mikeyfarrow/DFAM-x-ATMEGA/THT_PCB_rough-layout.PNG

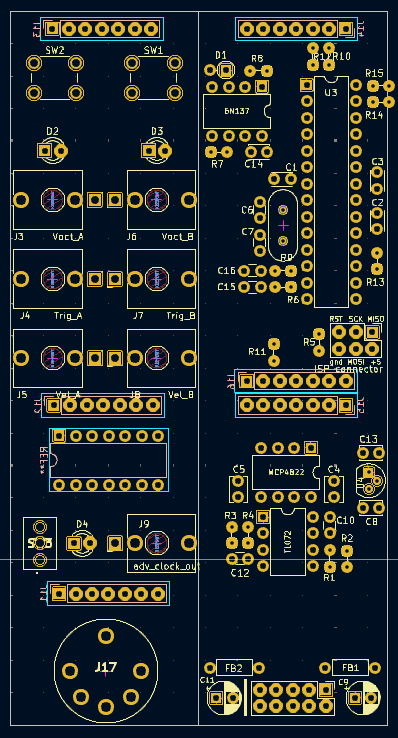
THT_PCB_rough-layout.PNG
