mikeyfarrow/DFAM-x-ATMEGA/PCB_Design_Kicad/fab/bom_JLCPCB_download.xls

Comment | Designator | Footprint | JLCPCB Part #
100n | C13,C1,C2,C3,C10,C12,C14,C13,C1,C2,C3,C10,C12,C14 | 0603 | C14663
47k | R2,R4,R16,R17 | 0603 | C25819
10u | C9,C11 | CP_Elec_5x5.4 | C263975
10k | R6,R9,R11,R12,R13,R15,R24 | 0603 | C25804
150n | C18 | 0603 | C21120
1N4148 | D1,D7 | SOD-323 | C2128
56k | R21,R23 | 0603 | C23206
33k | R20,R22 | 0603 | C4216
1k | R7,R18,R19 | 0603 | C21190
1u | C4,C15,C17 | 0603 | C15849
220R | R5,R8,R10,R14 | 0603 | C22962
OPA4196xD | U4 | TSSOP-14 | C2873620
DAC8562SDGSR | IC1 | VSSOP-10-0.5mm | C127965
6N137 | U5 | SMD8 | C92651
240k | R1,R3 | 0603 | C407611
0.33u | C8 | 0603 | C1623
ATmega328-A | U6 | TQFP-32_7x7mm_P0.8mm | C14877
rppdiode | D5,D6 | SOD-123F | C8598
18p | C5,C6,C7,C16 | 0603 | C1647
