mikeyfarrow/DFAM-x-ATMEGA/PCB_Design_Kicad/fab/panel_MIDIFAM.step

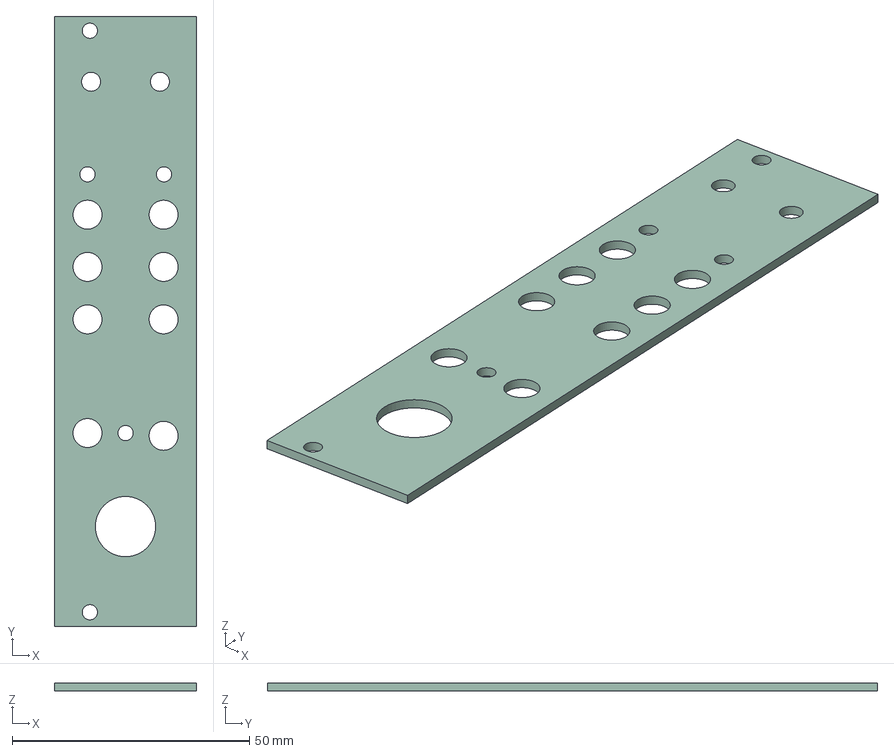
[picture p2: CAD file, 2024-08-22]
PCB_Design_Kicad/fab/panel_MIDIFAM.step
30.0 x 128.5 x 1.60 mm
