mikeyfarrow/DFAM-x-ATMEGA/PCB_Design_Kicad/fab/controls.step

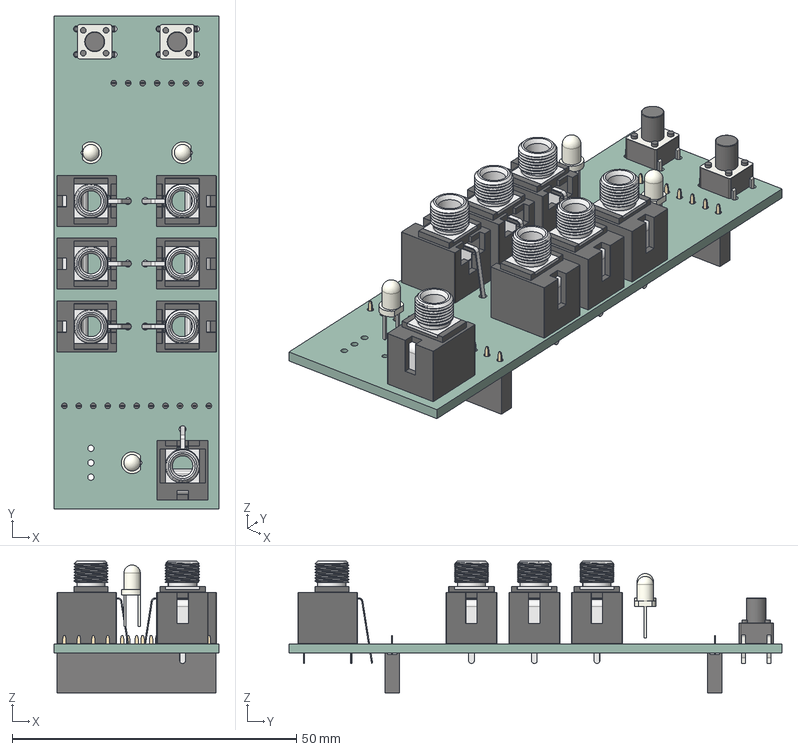
[picture p3: CAD file, 2024-08-22]
PCB_Design_Kicad/fab/controls.step
29.0 x 86.6 x 23.2 mm
LED_D3.0mm_Clear x 3
SW_PUSH_6mm_h8mm x 2
PinSocket_1x07_P254mm_Vertical
PinSocket_1x11_P254mm_Vertical
controls_PCB
