mikeyfarrow/DFAM-x-ATMEGA/PCB_Design_Kicad/fab/circuit.step

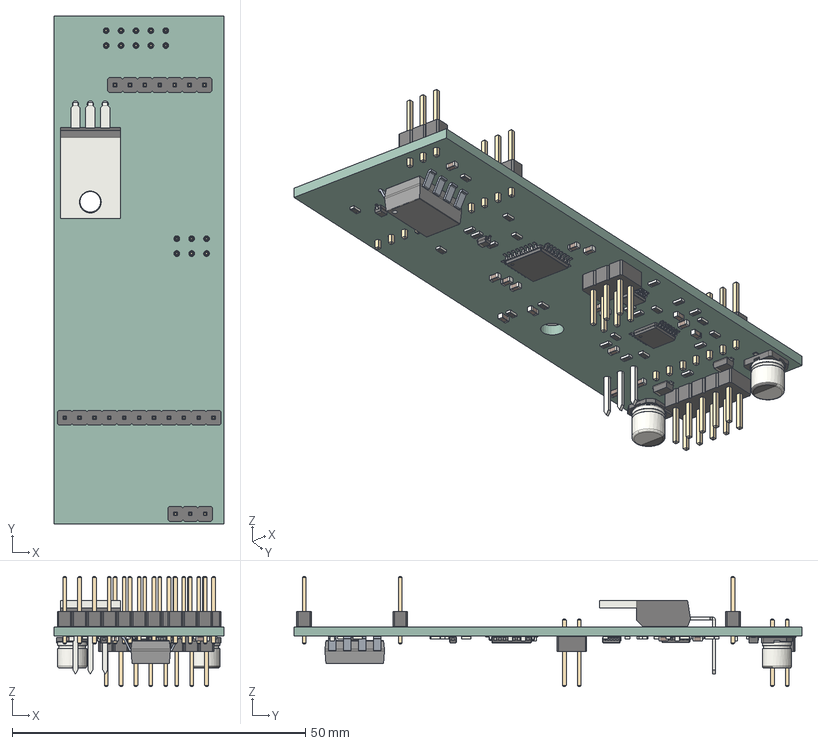
[picture p4: CAD file, 2024-08-22]
PCB_Design_Kicad/fab/circuit.step
29.0 x 86.6 x 18.8 mm
PinHeader_1x07_P254mm_Vertical
PinHeader_1x11_P254mm_Vertical
PinHeader_1x03_P254mm_Vertical
TO-220-3_Horizontal_TabUp
C_0603_1608Metric x 16
R_0603_1608Metric x 24
PinHeader_2x03_P254mm_Vertical
D_SOD_323 x 2
CP_Elec_5x54 x 2
TQFP_32_7x7mm_P08mm
D_SOD_123F x 2
ASSEMBLY
DGS0010A_ASM
PinHeader_2x05_P254mm_Vertical
TSSOP_14_44x5mm_P065mm
circuit_PCB
