mikeyfarrow/DFAM-x-ATMEGA/PCB_Design_Kicad/MIDIFAM.kicad_pcb

## KiCad design PCB_Design_Kicad/MIDIFAM.kicad_pcb (2024-08-22)

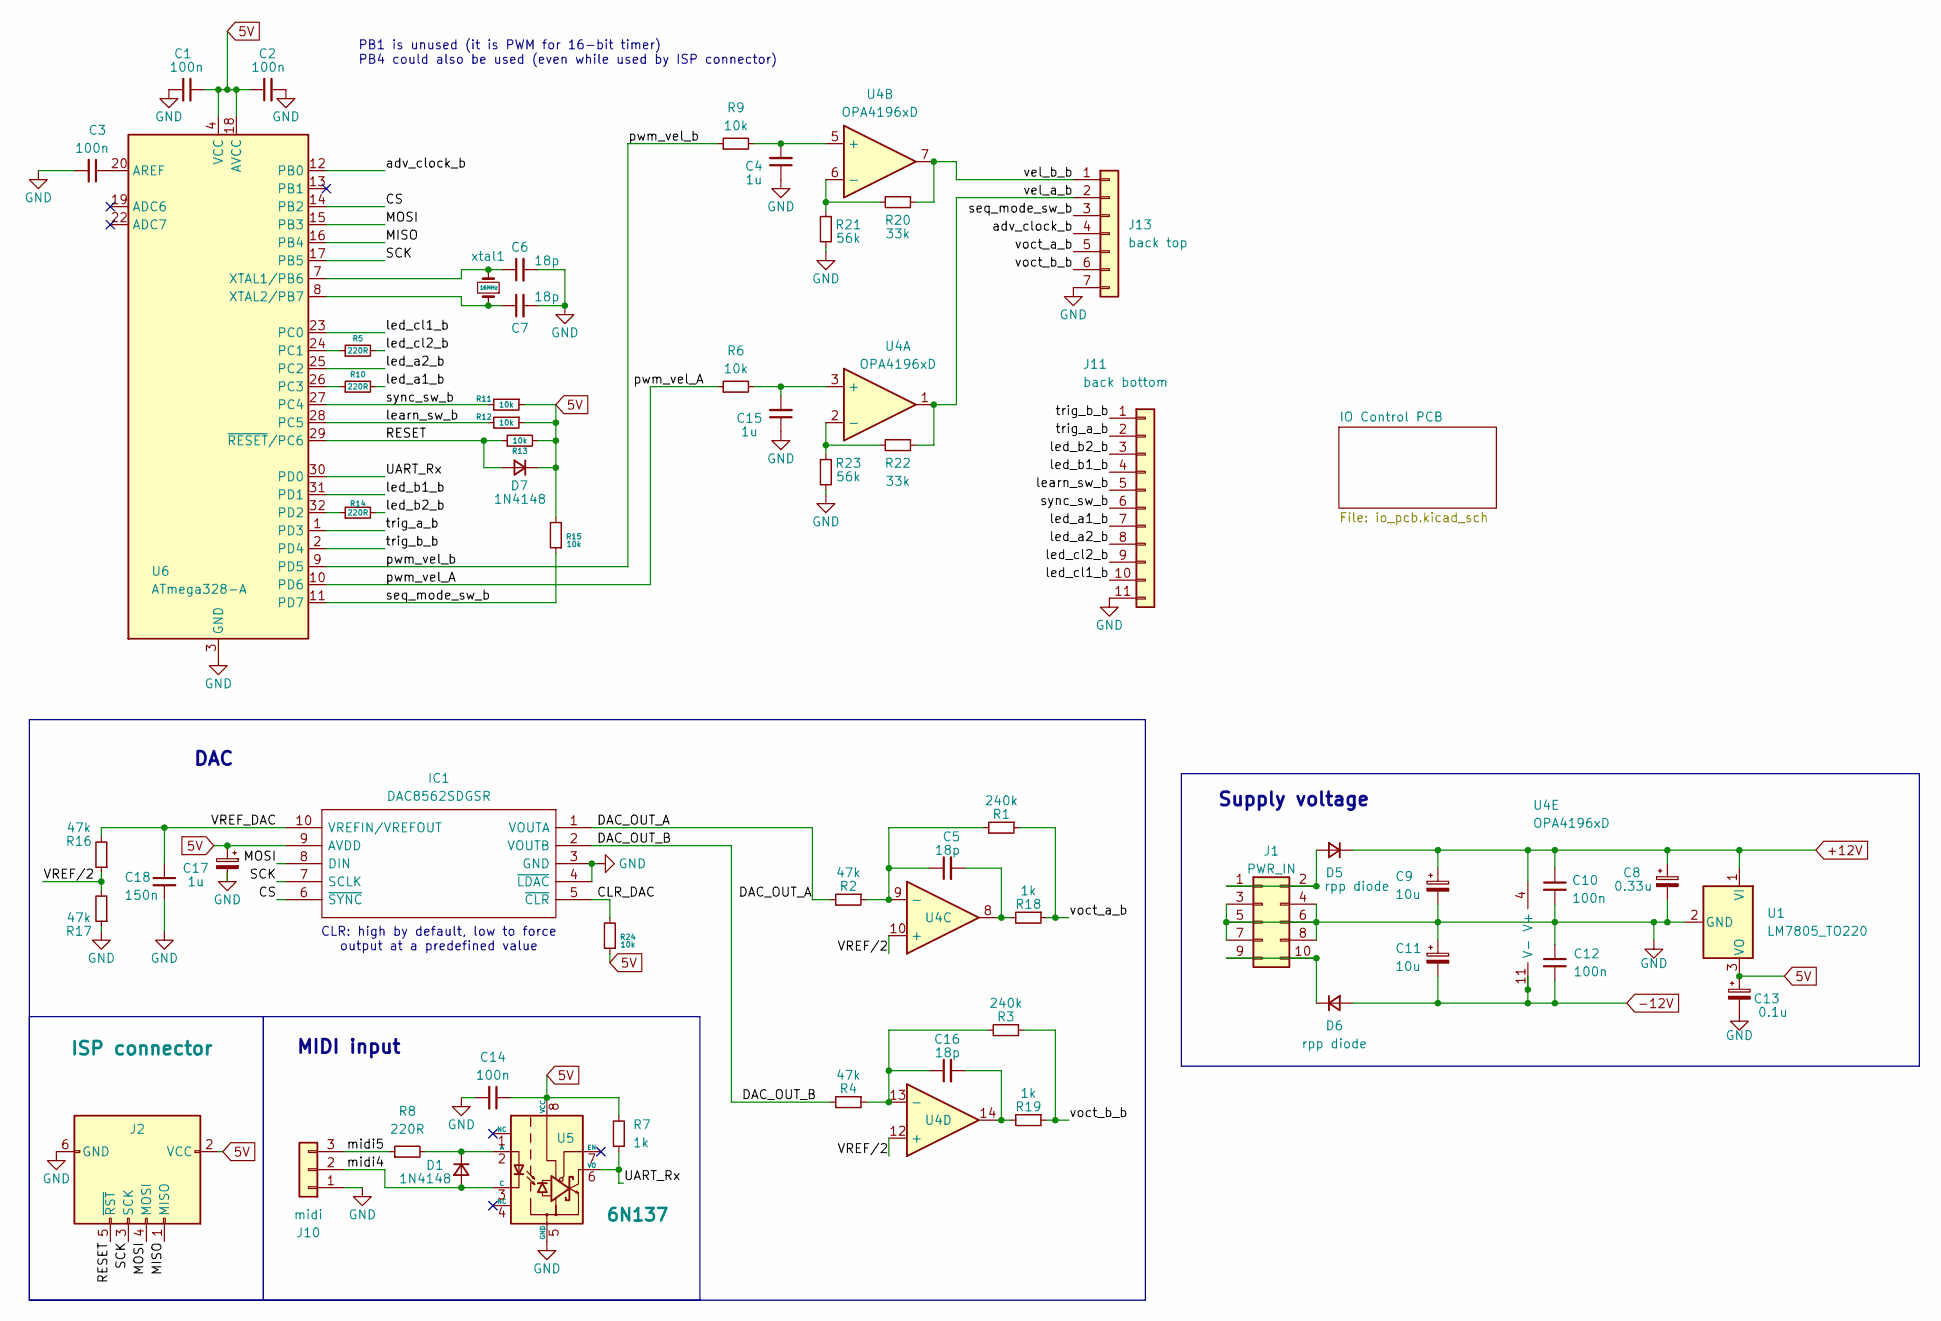
[picture p5: schematic MIDIFAM.kicad_sch]

Parts:
C1, C2, C3, C10, C12, C14: 100n; C_0603_1608Metric; LCSC C14663
C4, C15, C17: 1u; C_0603_1608Metric; LCSC C2691405
C5, C6, C7, C16: 18p; C_0603_1608Metric; LCSC C1647
C8: 0.33u; C_0603_1608Metric; LCSC C1623
C9, C11: 10u; CP_Elec_5x5.4; LCSC C263975
C13: 0.1u; C_0603_1608Metric; LCSC C14663
C18: 150n; C_0603_1608Metric; LCSC C464419
D1, D7: 1N4148; D_SOD-323_HandSoldering; LCSC C2128
D5, D6: rpp diode; D_SOD-123F; LCSC C8598
IC1: DAC8562SDGSR; SOP50P490X110-10N; Mouser Part Number 595-DAC8562SDGSR
J1: PWR_IN; PinHeader_2x05_P2.54mm_Vertical
J2: ISP connector; PinHeader_2x03_P2.54mm_Vertical
J10: midi; PinHeader_1x03_P2.54mm_Vertical
J11: back bottom; PinHeader_1x11_P2.54mm_Vertical
J13: back top; PinHeader_1x07_P2.54mm_Vertical
R1, R3: 240k; R_0603_1608Metric_Pad0.98x0.95mm_HandSolder; LCSC C407611
R2, R4, R16, R17: 47k; R_0603_1608Metric_Pad0.98x0.95mm_HandSolder; LCSC C25819
R5, R8, R10, R14: 220R; R_0603_1608Metric_Pad0.98x0.95mm_HandSolder; LCSC C22962
R6, R9, R11, R12, R13, R15, R24: 10k; R_0603_1608Metric_Pad0.98x0.95mm_HandSolder; LCSC C25804
R7, R18, R19: 1k; R_0603_1608Metric_Pad0.98x0.95mm_HandSolder; LCSC C21190
R20, R22: 33k; R_0603_1608Metric_Pad0.98x0.95mm_HandSolder; LCSC C4216
R21, R23: 56k; R_0603_1608Metric_Pad0.98x0.95mm_HandSolder; LCSC C23206
U1: LM7805_TO220; TO-220-3_Horizontal_TabUp
U4: OPA4196xD; TSSOP-14_4.4x5mm_P0.65mm; LCSC C2873620
U5: 6N137; SOP254P1005X465-8N; LCSC C92651
U6: ATmega328-A; TQFP-32_7x7mm_P0.8mm; LCSC C14877
xtal1: 16MHz; XT9M20ANA20M

Connections:
5V: C1.1, C2.1, C13.1, C14.1, C17.1, D7.1 (K), IC1.9 (AVDD), J2.2 (VCC), R7.2, R11.1, R12.1, R13.2, R15.2, R24.1, U1.3 (VO), U5.8 (VCC), U6.4 (VCC), U6.6 (VCC), U6.18 (AVCC)
+12V: C8.1, C9.1, C10.1, D5.1 (K), U1.1 (VI), U4.4 (V+)
-12V: C11.2, C12.2, D6.2 (A), U4.11 (V-)
/CLR_DAC: IC1.5 (~CLR), R24.2
/CS: IC1.6 (~SYNC), U6.14 (PB2)
/DAC_OUT_A: IC1.1 (VOUTA), R2.2
/DAC_OUT_B: IC1.2 (VOUTB), R4.2
/MISO: J2.1 (MISO), U6.16 (PB4)
/MOSI: IC1.8 (DIN), J2.4 (MOSI), U6.15 (PB3)
/RESET: D7.2 (A), J2.5 (~RST), R13.1, U6.29 (~RESET/PC6)
/SCK: IC1.7 (SCLK), J2.3 (SCK), U6.17 (PB5)
/UART_Rx: R7.1, U5.6 (VO), U6.30 (PD0)
/VREF_DAC: C18.1, IC1.10 (VREFIN/VREFOUT), R16.2
/VREF/2: R16.1, R17.2, U4.10 (+), U4.12 (+)
/adv_clock_b: J13.4, U6.12 (PB0)
/learn_sw_b: J11.5, R12.2, U6.28 (PC5)
/led_a1_b: J11.7, R10.2
/led_a2_b: J11.8, U6.25 (PC2)
/led_b1_b: J11.4, U6.31 (PD1)
/led_b2_b: J11.3, R14.2
/led_cl1_b: J11.10, U6.23 (PC0)
/led_cl2_b: J11.9, R5.2
/midi4: D1.2 (A), J10.2, U5.3 (C)
/midi5: J10.3, R8.1
/pwm_vel_A: R6.1, U6.10 (PD6)
/pwm_vel_b: R9.1, U6.9 (PD5)
/seq_mode_sw_b: J13.3, R15.1, U6.11 (PD7)
/sync_sw_b: J11.6, R11.2, U6.27 (PC4)
/trig_a_b: J11.2, U6.1 (PD3)
/trig_b_b: J11.1, U6.2 (PD4)
/vel_a_b: J13.2, R22.1, U4.1
/vel_b_b: J13.1, R20.1, U4.7
/voct_a_b: J13.5, R1.1, R18.1
/voct_b_b: J13.6, R3.1, R19.1
GND: C1.2, C2.2, C3.2, C4.1, C6.2, C7.2, C8.2, C9.2, C10.2, C11.1, C12.1, C13.2, C14.2, C15.1, C17.2, C18.2, IC1.3 (GND), IC1.4 (~LDAC), J1.3, J1.4, J1.5, J1.6, J1.7, J1.8, J2.6 (GND), J10.1, J11.11, J13.7, R17.1, R21.2, R23.2, U1.2 (GND), U5.5 (GND), U6.3 (GND), U6.5 (GND), U6.21 (GND); also elsewhere on the board
unnamed: C5.2, R18.2, U4.8
unnamed: C16.2, R19.2, U4.14
unnamed: D1.1 (K), R8.2, U5.2 (A)
unnamed: D5.2 (A), J1.1, J1.2
unnamed: D6.1 (K), J1.9, J1.10
unnamed: C15.2, R6.2, U4.3 (+)
unnamed: R22.2, R23.1, U4.2 (-)
unnamed: C4.2, R9.2, U4.5 (+)
unnamed: R20.2, R21.1, U4.6 (-)
unnamed: C5.1, R1.2, R2.1, U4.9 (-)
unnamed: C16.1, R3.2, R4.1, U4.13 (-)
unnamed: C3.1, U6.20 (AREF)
unnamed: R5.1, U6.24 (PC1)
unnamed: R10.1, U6.26 (PC3)
unnamed: R14.1, U6.32 (PD2)
unnamed: C6.1, U6.7 (XTAL1/PB6), xtal1.2
unnamed: C7.1, U6.8 (XTAL2/PB7), xtal1.1

Notes on the sheet:
MIDI input
CLR: high by default, low to force output at a predefined value
Supply voltage
PB1 is unused (it is PWM for 16-bit timer) PB4 could also be used (even while used by ISP connector)
DAC

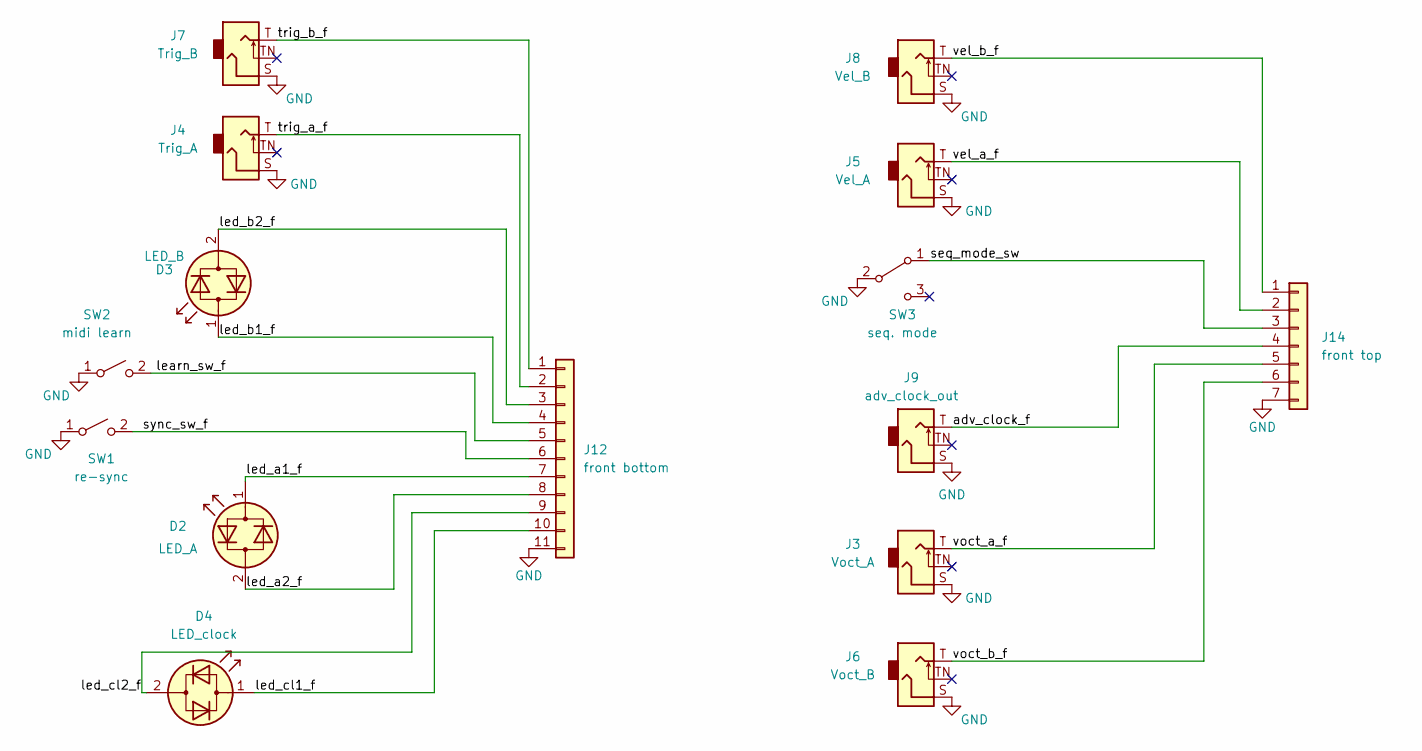
[picture p6: schematic io_pcb.kicad_sch]

Parts:
D2: LED_A; LED_D3.0mm_Clear
D3: LED_B; LED_D3.0mm_Clear
D4: LED_clock; LED_D3.0mm_Clear
J3: Voct_A; Thonkiconn
J4: Trig_A; Thonkiconn
J5: Vel_A; Thonkiconn
J6: Voct_B; Thonkiconn
J7: Trig_B; Thonkiconn
J8: Vel_B; Thonkiconn
J9: adv_clock_out; Thonkiconn
J12: front bottom; PinSocket_1x11_P2.54mm_Vertical
J14: front top; PinSocket_1x07_P2.54mm_Vertical
SW1: re-sync; SW_PUSH_6mm_H8mm
SW2: midi learn; SW_PUSH_6mm_H8mm
SW3: seq. mode; submini

Connections:
/IO Control PCB/adv_clock_f: J9.T, J14.4
/IO Control PCB/learn_sw_f: J12.5, SW2.2 (B)
/IO Control PCB/led_a1_f: D2.1 (KA), J12.7
/IO Control PCB/led_a2_f: D2.2 (AK), J12.8
/IO Control PCB/led_b1_f: D3.1 (KA), J12.4
/IO Control PCB/led_b2_f: D3.2 (AK), J12.3
/IO Control PCB/led_cl1_f: D4.1 (KA), J12.10
/IO Control PCB/led_cl2_f: D4.2 (AK), J12.9
/IO Control PCB/seq_mode_sw: J14.3, SW3.1 (A)
/IO Control PCB/sync_sw_f: J12.6, SW1.2 (B)
/IO Control PCB/trig_a_f: J4.T, J12.2
/IO Control PCB/trig_b_f: J7.T, J12.1
/IO Control PCB/vel_a_f: J5.T, J14.2
/IO Control PCB/vel_b_f: J8.T, J14.1
/IO Control PCB/voct_a_f: J3.T, J14.5
/IO Control PCB/voct_b_f: J6.T, J14.6
GND: J3.S, J4.S, J5.S, J6.S, J7.S, J8.S, J9.S, J12.11, J14.7, SW1.1 (A), SW2.1 (A), SW3.2 (B); also elsewhere on the board

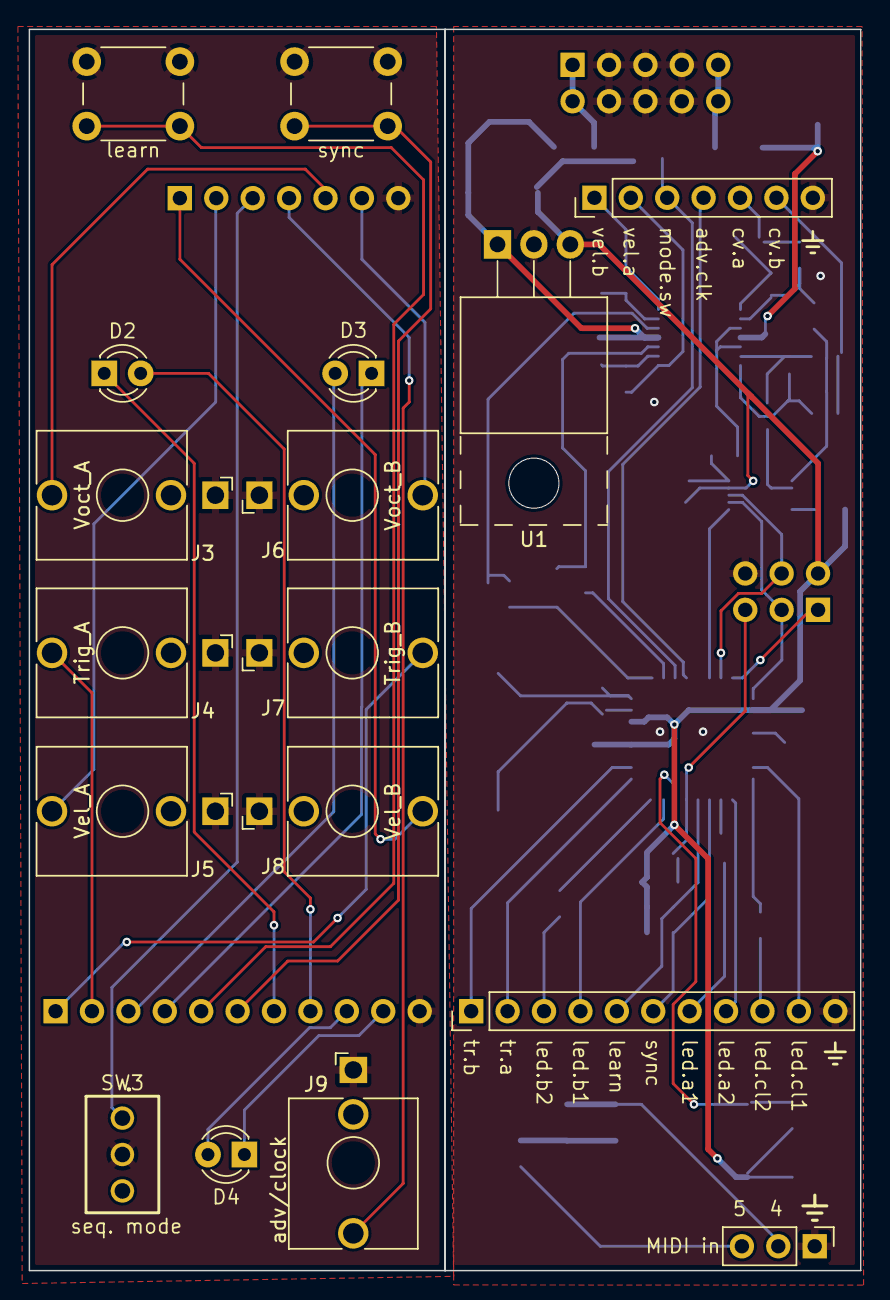
[picture p7: board MIDIFAM.kicad_pcb from above]

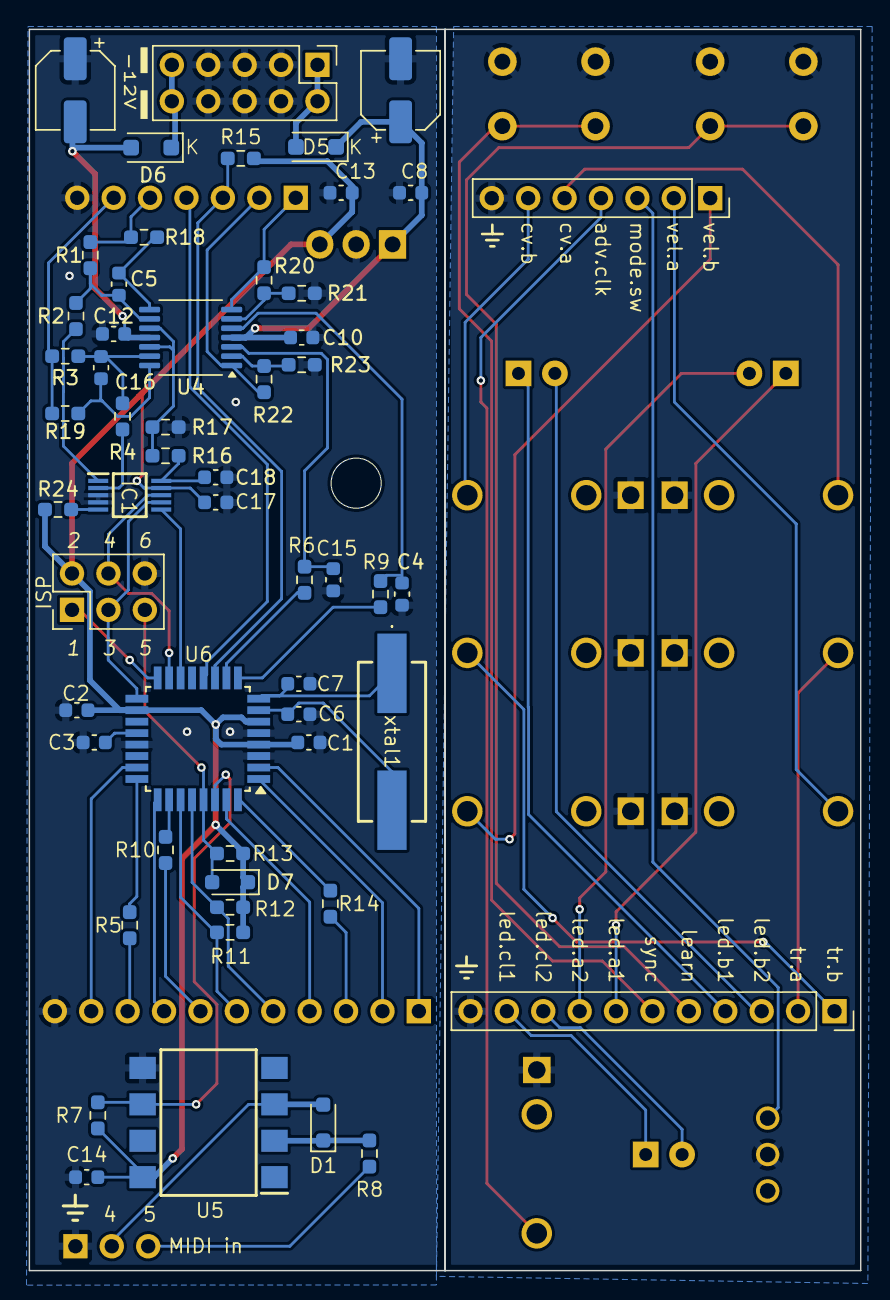
[picture p8: board MIDIFAM.kicad_pcb from below]

Board: 2 copper layers, 58.0 x 86.6 mm, 72 parts (55 on the bottom side), 68 nets.
