mikeyfarrow/DFAM-x-ATMEGA/(commit log)

2024-07-03 include copy of arduino MIDI lib
2024-07-03 replaced transport with empty implementation
    [main.cpp]
2024-07-04 checkpoint: midi byte loopback working, debug LED banks, and MIDI.h linked
2024-07-04 working implementation of MIDI Rx via midi cable
2024-07-06 initialize SPI for DAC and test 12 bit output
2024-07-06 add trigger timer and eeprom_writer class
2024-07-07 fixing last two broken commits
    [main.cpp]
2024-07-08 code cleanup, putting away encoder for now because my last encoder is broken
    [main.cpp]
2024-07-08 implement switch input, added led back to bank, debounced switch
2024-07-08 hooking up PWM outputs on timer 0, move trigger interrupts and switch debounce to timer1
2024-07-08 filtered PWM outputs working for velocity
2024-07-09 reduced note range to 88 notes, added sync button, remapped KCS mode to c major
2024-07-10 fixing bug where sequence un-syncs when switching from CCS to KCS
    [main.cpp]
2024-07-11 apply velocity and v/oct before trigger
2024-07-11 fix velocity calculation and increase PWM to above audio range (62.5kHz)
    [GPIO.cpp, MidiController.cpp, main.cpp]
2024-07-16 major feature updates: 1. portamento for v/oct, and 2. full MIDI output with Tx ready interrupt
2024-07-19 implement pitch bend + major perf improvements + skeleton of vibrato
    [CvOutput.cpp, CvOutput.h, GPIO.cpp, GPIO.h, MidiController.cpp, MidiController.h, SerialMidiTransport.cpp, main.cpp]
2024-07-20 added vibrato with CCs for control
    [CvOutput.cpp, CvOutput.h, MidiController.cpp, MidiController.h]
2024-07-20 fixed phase of triangle wave vibrato
    [CvOutput.cpp, CvOutput.h]
2024-07-22 fixed midi note range bug. added initial sketch for polyphonic / note priority ideas
    [CvOutput.cpp, CvOutput.h, MidiController.cpp, MidiController.h, main.cpp]
2024-07-23 added midi channel select mode; added asc/desc portamento CCs; fixed DAC data overflow bugs
    [CvOutput.cpp, CvOutput.h, GPIO.cpp, GPIO.h, MidiController.cpp, MidiController.h, main.cpp]
2024-07-23 vibrato and portamento concurrently; initial BPM detection math
    [CvOutput.cpp, CvOutput.h, MidiController.cpp, MidiController.h, main.cpp]
2024-07-23 better tempo sync'd delay - can switch on and off. todo: apply vibrato delay at note_on, don't update with every cc
    [CvOutput.cpp, CvOutput.h, MidiController.h]
2024-08-02 initial digital calibration logic; save and load to/from EEPROM
2024-08-02 LFO mode (halfwave, rectified, bipolar) for vibrato
    [CvOutput.cpp, CvOutput.h, MidiController.cpp, MidiController.h, main.cpp]
2024-08-03 push button events with keyboard learn mode; better cc ranges for most params
2024-08-03 adding kicad schematic and PCB drafts
    [MIDIFAM.kicad_pcb, MIDIFAM.kicad_sch, io_pcb.kicad_sch, panel_MIDIFAM.kicad_pcb]
2024-08-09 SMD pcb, routable and with vias
    [MIDIFAM.kicad_pcb, MIDIFAM.kicad_sch, io_pcb.kicad_sch]
2024-08-09 routed SMD
    [MIDIFAM.kicad_pcb, MIDIFAM.kicad_sch, io_pcb.kicad_sch]
2024-08-09 better routing
    [MIDIFAM.kicad_pcb, MIDIFAM.kicad_sch, io_pcb.kicad_sch]
2024-08-10 fix footprints and jack position
    [MIDIFAM.kicad_pcb]
2024-08-10 good routing and ground planes
    [MIDIFAM.kicad_pcb]
2024-08-11 ready for schematic review
    [MIDIFAM.kicad_pcb, MIDIFAM.kicad_sch]
2024-08-12 op amps for velocity!
    [MIDIFAM.kicad_pcb, MIDIFAM.kicad_sch]
2024-08-12 updating code to work with new LED setup
2024-08-13 adding to BOM
    [MIDIFAM.kicad_pcb, MIDIFAM.kicad_sch, io_pcb.kicad_sch]
2024-08-13 more bom
    [MIDIFAM.kicad_pcb, MIDIFAM.kicad_sch]
2024-08-22 pcb versions sent to jlcpcb
    [MIDIFAM.kicad_pcb, MIDIFAM.kicad_sch, bom_JLCPCB_download.xls, circuit.kicad_pcb, circuit.step, controls.kicad_pcb, controls.step, io_pcb.kicad_sch]
